Ochaligne/IoT-carbon-dioxide-wireless-sensor-arduino/README.md

# IoT-carbon-dioxide-wireless-sensor-arduino
Arduino based wireless radio carbon dioxide sensor.

See the accompanying project report (pdf) for in depth details.
